m3l1k4/Capstone_F19_Group_110/3D CAD/smarties-16.JPG

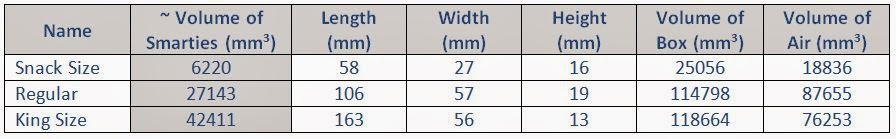
3D CAD/smarties-16.JPG
