m3l1k4/Capstone_F19_Group_110/documents/proposal/20191010 - Presentation.pptx

## Recap

- Over last two weeks,
  - Started brainstorming solutions for product
  - Compiling list of components we need and the anticipated cost
- Met with client yesterday
  - Primary contact + technical contact present
  - Discussed potential solutions that will integrate within their POS system
    - The system is a black box , so this is important

## RCGs

Requirements | Constraints | Goals
Wireless communication (between end and edge device) | End to edge must use low power , low bandwidth protocol. Ex; zigbee | Scalable
Low power consumption (IoT) | End to cloud must be use high bandwidth ex; wifi or ethernet | Low production cost
MS Azure
Real time data handling

## Should have

- Wireless communication
- low power consumption
- Configure to handle microsoft Azure API
- Scalable
- Real time data handling

## Could Have or nice to have

- Run on rechargeable batteries
- Minimalistic azure developed UI

## Will not have ( at this time)

- Multiple end devices
- Interchangeable high bandwidth communication protocol ( i.e. can switch from http to mqtt depending on the environment)
- Interchangeable low bandwidth protocol

## Overview of System

Upstream; Azure IoT hub

Data abstraction middle layer

Container 1

s1

s2

s3

Container 2

s1

s2

s3

Container 3

s1

s2

s3

1. End device (with weight sensor) sends data to Edge device (middle layer) via IoT protocol. Zigbee is being considered.
2. Edge device sends data to Azure IoT Cloud via internet protocol (Wifi, Ethernet)
3. User is able to access data from End devices from Azure Interface

## Slide 7

End Device

Low band communication and processing unit

sensors

Edge Device

low band com processing unit

Processing RAM

High band communication unit

IoT Hub

## Milestones

1. Individual hardware components at a functional level
  a. End device (sensor + communication module)
  b. Edge device (communication module for end device and IoT)
2. Integration into one system
  a. End device to Edge device
  b. Edge device to IoT Hub
3. MS Azure User Interface
  a. Develop a UI using MS Azure

## Project Timeline

- Design will be finalized soon after proposal
- Begin ordering misc parts as soon as account is open
  - Client is checking their inventory for dev boards and suggested to order major components under $100 through.
  - We are checking our own inventory from previous projects
- 2-3 weeks per ‘mini project’: configuration + troubleshooting

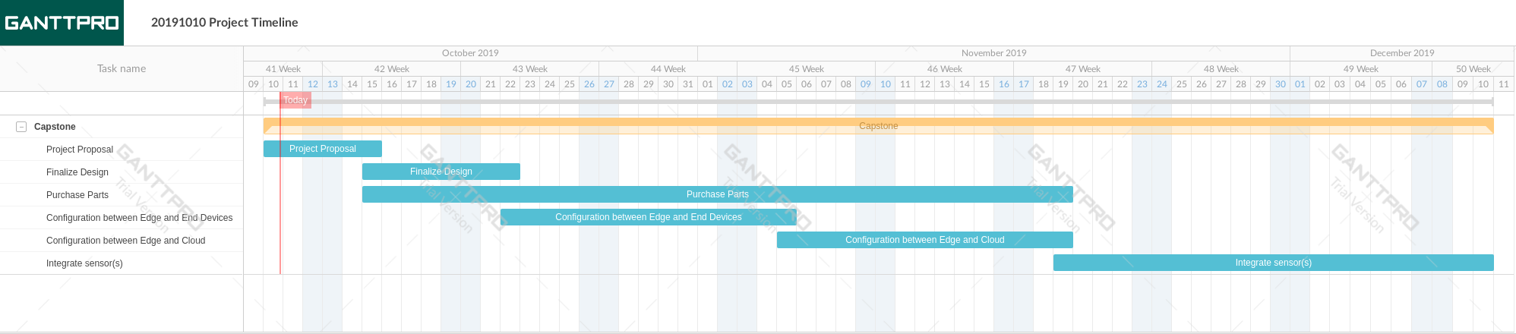
[picture p14: figure]

## Technical Task Distribution based on skill-set

| Ammar | Melika | Wency | Adil
Skill Area | Low bandwidth Communication protocols integration ( end devices) | Cloud integration ( edge devices) | Data handling software , and software QA | Hardware-software integration
Notes of concern | Currently out of the country. Anticipated to be back on the 14th | | | Laptop recently water damaged

## Non-technical task distribution

- We all are communicating through one email screen name, so admin tasks have been done based on who is free to do it the earliest
- Everyone is listed as a delegate and has access to mailbox
- This is run quickly by other members either in person or in memos, to avoid duplicate emails, tasks etc.

Notes: To do : azure email
