m3l1k4/Capstone_F19_Group_110/Meeting Notes/software achitecture 20190131.docx

IoT inventory software architecture
End Device
Intermediate connection XBEE
Edge Device
load sensor to arduino
weight data calib*
xbee to pi
Xbee
arduino to xbee
xbee string prep
Load Sensor Read
Load Sensor data QA ( -1,0,1)
pi to azure
Send Data
String: { weight, device ID etc.}
Read xbee serial data ( libraries)
use voltage-weight ratio table or send raw data*
wait for ping from pi to send
Ping End Device to request data
Wait for data
Ping End device to confirm reciept
(will need if getting raw data)
send
wait for reciept confirmation
ISR for data retrieving from multiple end devices
clean up string
format data values for table insertion
(only one string can be sent per API request)
recieve from formatter function
start API request to insert
Get Data
( this script already exists)
( this script already exists)
(Arduino Xbee libraries for sending data)
