m3l1k4/Capstone_F19_Group_110/minicloud/minicloud-master/Architecture/AWS_IoT.png

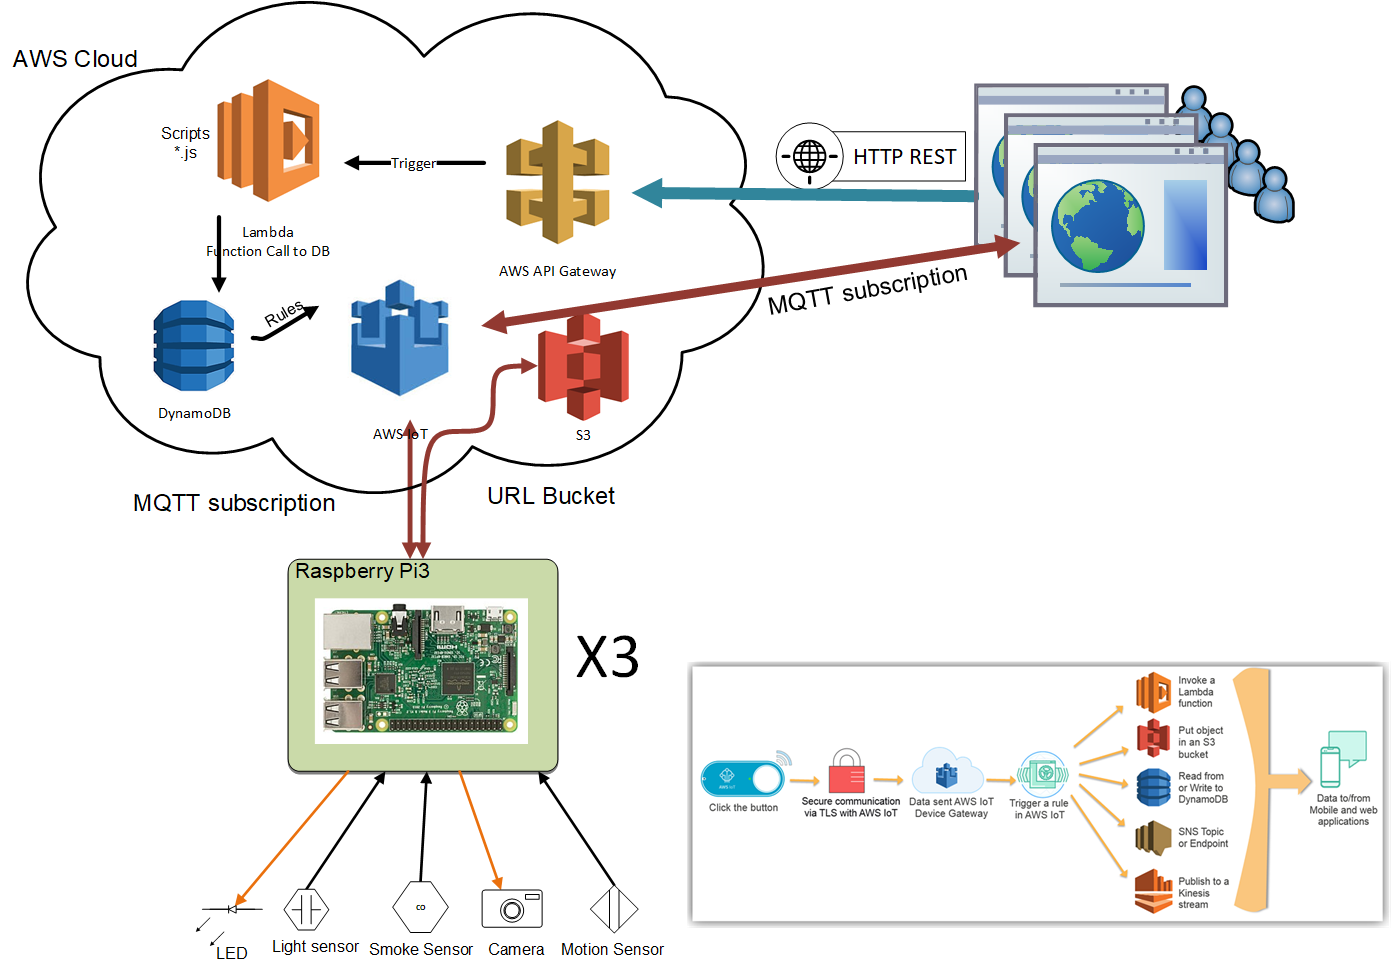
minicloud/minicloud-master/Architecture/AWS_IoT.png
