m3l1k4/Capstone_F19_Group_110/minicloud/minicloud-master/Architecture/template_xml_json.PNG

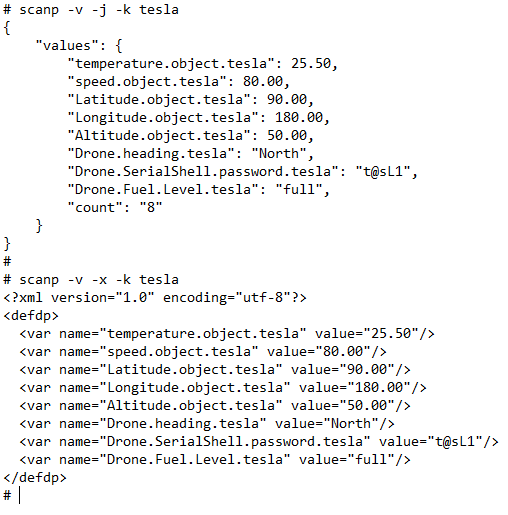
minicloud/minicloud-master/Architecture/template_xml_json.PNG
