m3l1k4/Capstone_F19_Group_110/Capstone Parts.xlsx

Manufacturer | Manufacturer Part Number | Seller | Digi-Key Part Number | Quantity | Link | Description | Unit Price | Net Price
DFRobot | DFR0015 | Digi-Key | 1738-1230-ND | 1 | https://tinyurl.com/y4jpyzoq | XBEE SHIELD FOR ARDUINO | 15.91 | 15.91
SparkFun Electronics | WRL-11812 | Digi-Key | 1568-1305-ND | 1 | https://tinyurl.com/yynkofbn | SPARKFUN XBEE EXPLORER USB | 37.13 | 37.13
Siretta Ltd | DELTA8A/X/SMAM/RP/S/17 - GREY | Digi-Key | DELTA8A/X/SMAM/RP/S/17-GREY-ND | 2 | https://tinyurl.com/y3pwvsl9 | RF ANT 2.4GHZ WHIP STR RP-SMA ML | 9.59 | 19.18
Digi International | XBP24CZ7SIT-004 | Digi-Key | 602-1562-ND | 2 | https://tinyurl.com/yxoxxojz | RF TXRX MODULE 802.15.4 RP-SMA | 49.62 | 99.24
 |  |  |  |  |  |  | Total Price | 171.46
