m3l1k4/Capstone_F19_Group_110/Solidworks files/Milestone 3.SLDASM

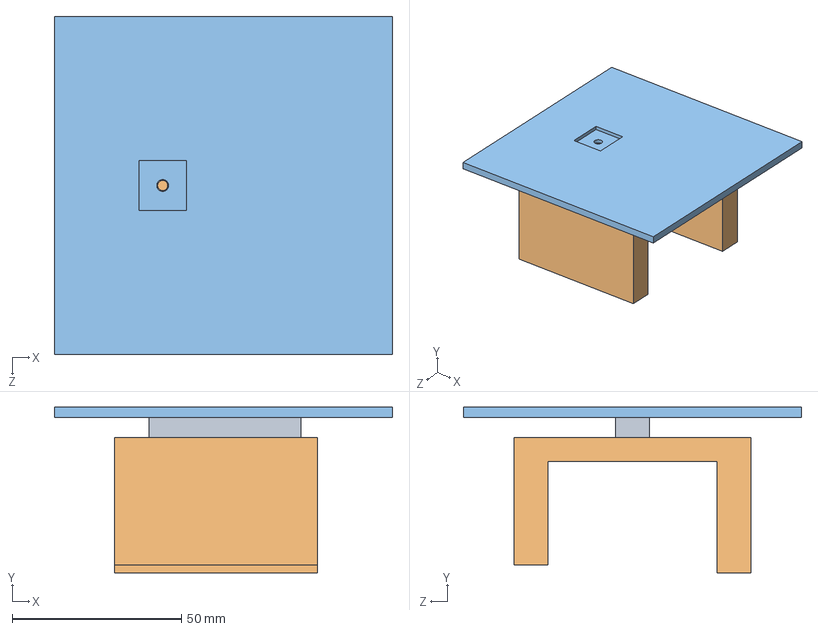
[picture p47: CAD file, 2020-02-27]
Solidworks files/Milestone 3.SLDASM
100.0 x 49.0 x 100.0 mm
Load cell
Load cell dock
Pressure plate proto
