m3l1k4/Capstone_F19_Group_110/3D CAD/dispneser 150x150 v26.stl

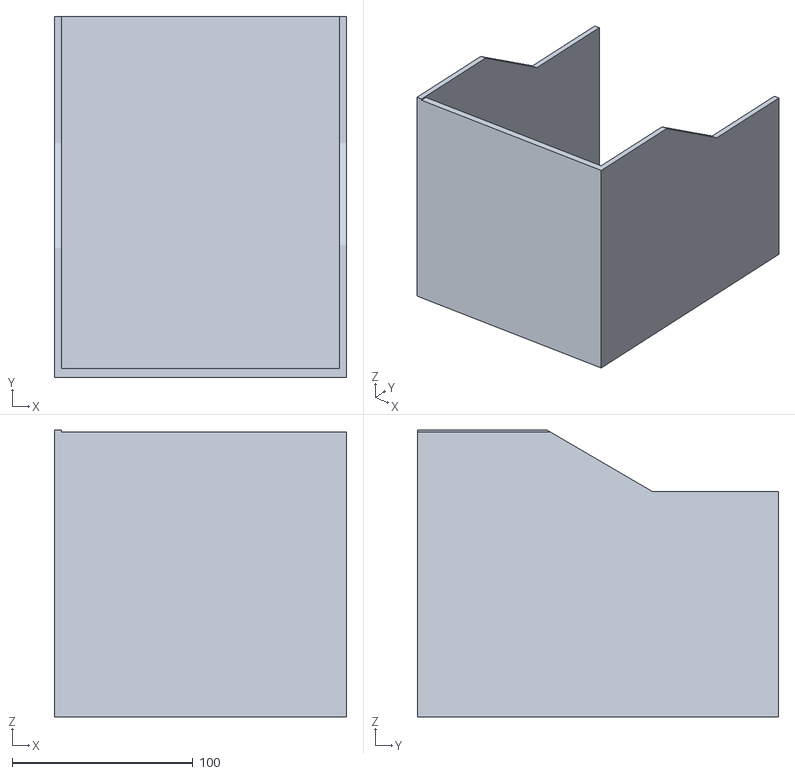
[picture p48: CAD file, 2020-03-04]
3D CAD/dispneser 150x150 v26.stl
161.9 x 200.0 x 159.0
