m3l1k4/Capstone_F19_Group_110/Solidworks files/Load cell dock.SLDPRT

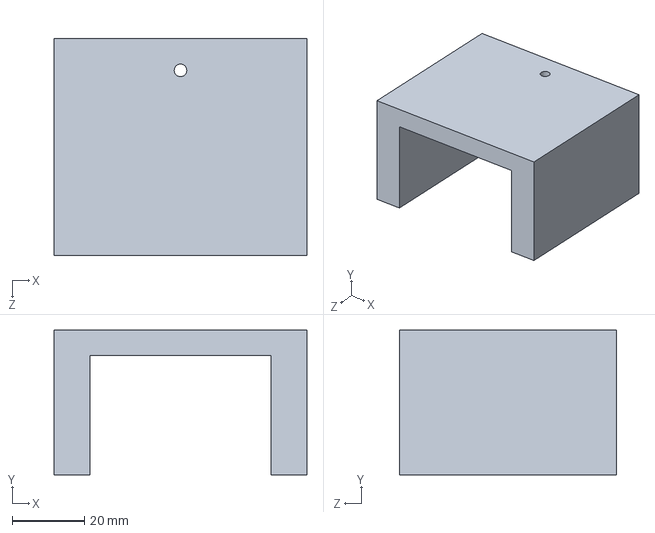
[picture p49: CAD file, 2020-04-04]
Solidworks files/Load cell dock.SLDPRT
70.0 x 40.0 x 60.0 mm
