m3l1k4/Capstone_F19_Group_110/Solidworks files/Load cell.SLDPRT

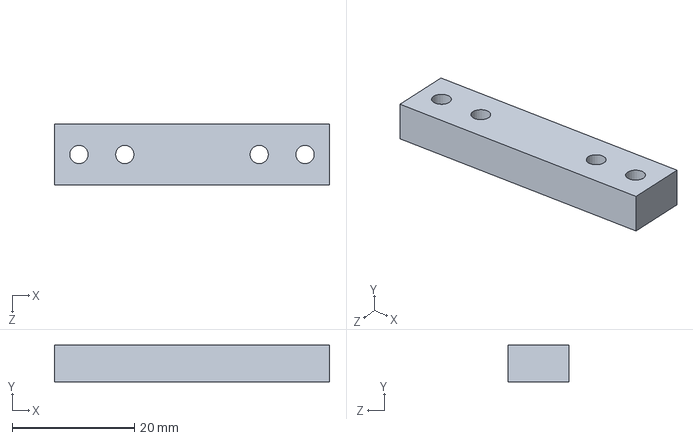
[picture p50: CAD file, 2020-02-27]
Solidworks files/Load cell.SLDPRT
45.0 x 6.00 x 10.0 mm
