m3l1k4/Capstone_F19_Group_110/Solidworks files/Pressure plate proto.SLDPRT

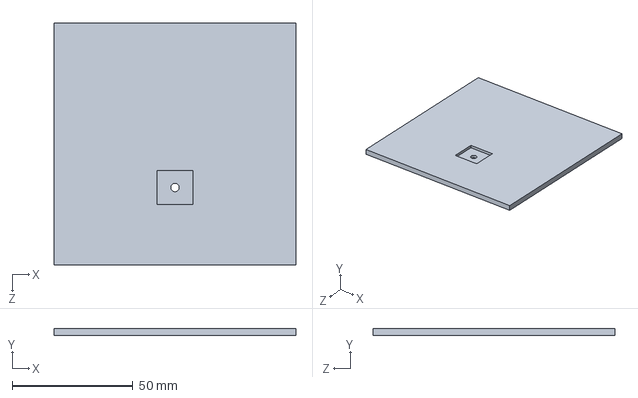
[picture p51: CAD file, 2020-02-27]
Solidworks files/Pressure plate proto.SLDPRT
100.0 x 3.00 x 100.0 mm
