m3l1k4/Capstone_F19_Group_110/(list of files, cad)

Other CAD files:
Solidworks files/Load cell dock.SLDDRW
Solidworks files/Load cell dock.STL
Solidworks files/Pressure plate proto.SLDDRW
Solidworks files/Pressure plate proto.STL
