m3l1k4/Capstone_F19_Group_110/Meeting Notes/software achitecture 20190130.pdf

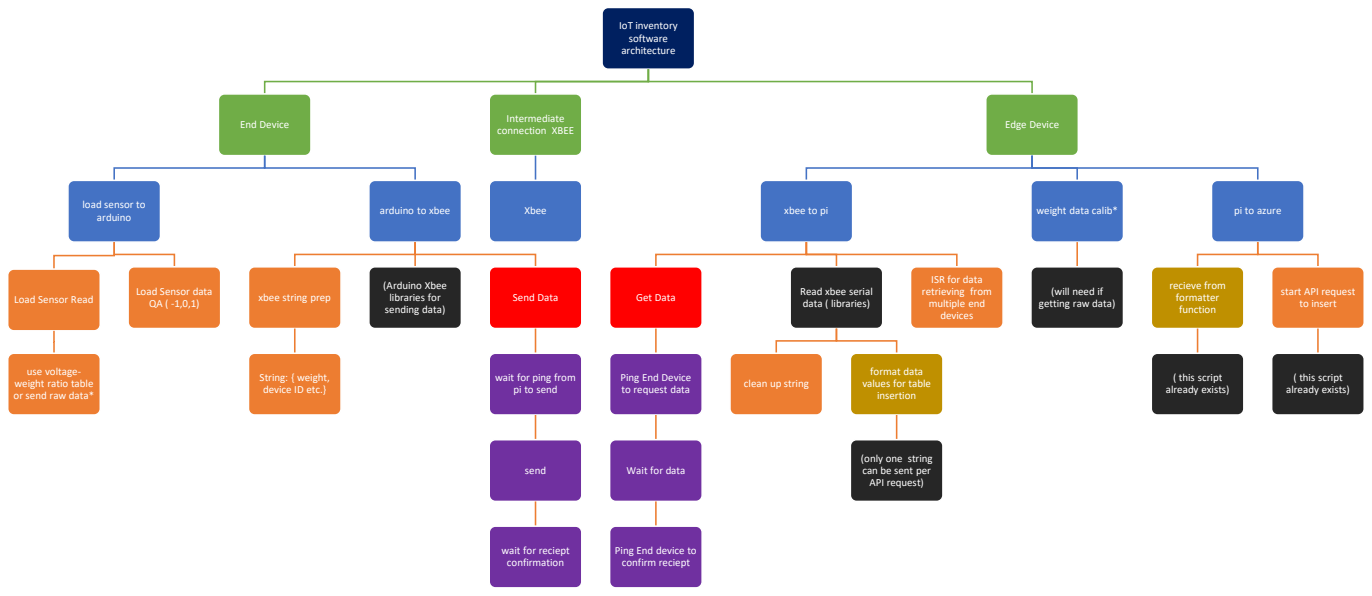
[picture p53: page 1]
IoT inventory software architecture; End Device; (Arduino Xbee libraries for sending data); Send Data; send; Intermediate connection XBEE; Xbee; Edge Device; Get Data; recieve from formatter function; ( this script already exists)

load sensor to
arduino

arduino to xbee

xbee to pi

weight data calib*

pi to azure

ISR for data
retrieving from
multiple end
devices

Load Sensor data

xbee string prep

Read xbee serial
data ( libraries)

(will need if
getting raw data)

start API request
to insert

Load Sensor Read

use voltage-
weight ratio table
or send raw data*

format data
values for table
insertion

String: { weight,
device ID etc.}

wait for ping from
pi to send

Ping End Device
to request data

clean up string

(only one string
can be sent per
API request)

Wait for data

wait for reciept
confirmation

Ping End device to
confirm reciept
