m3l1k4/Capstone_F19_Group_110/Load_cell/HX711-Load-Cell-Amplifier-master/HX711-Load-Cell-Amplifier-master/Production/SparkFun_HX711_Load_Cell-Panel-v11.brd

## EAGLE design Load_cell/HX711-Load-Cell-Amplifier-master/HX711-Load-Cell-Amplifier-master/Production/SparkFun_HX711_Load_Cell-Panel-v11.brd (2020-04-04)

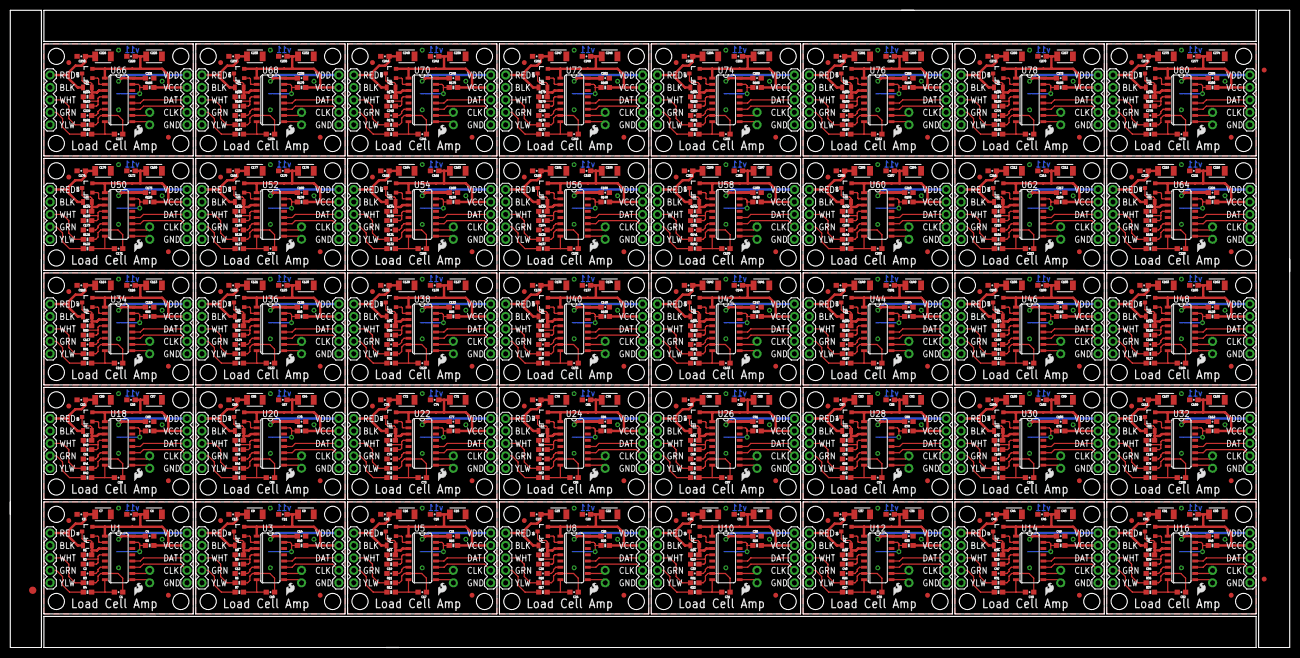
[picture p57: board SparkFun_HX711_Load_Cell-Panel-v11.brd from above]

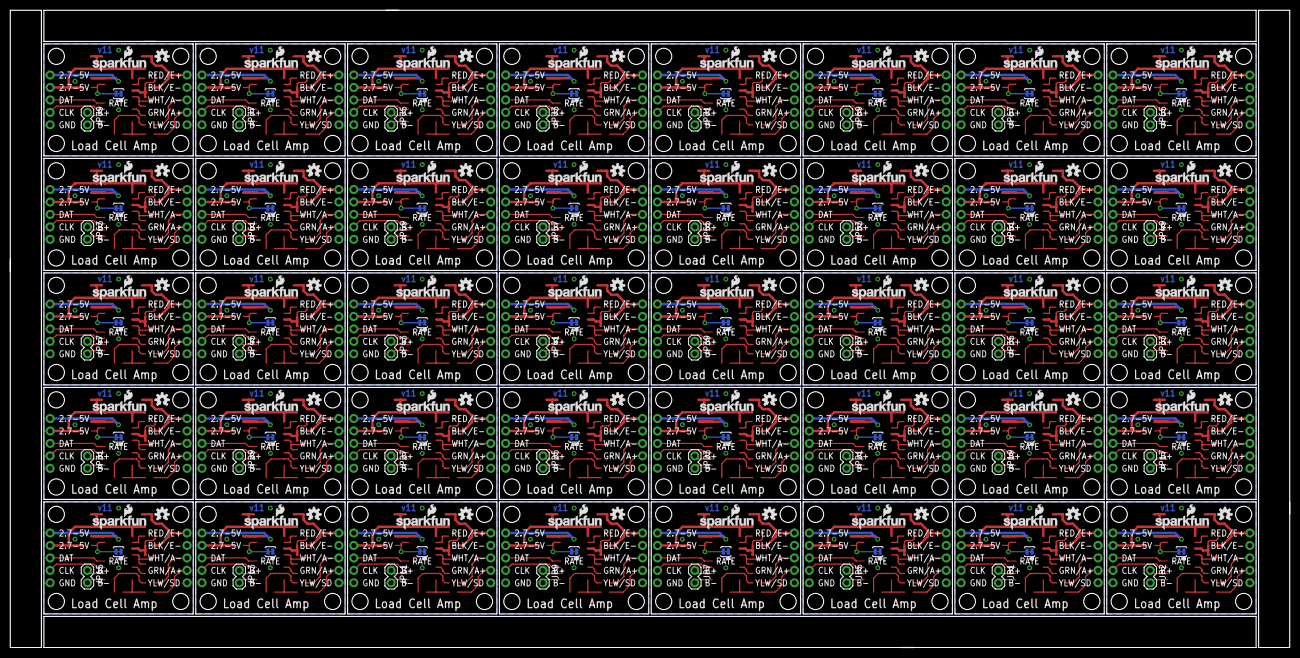
[picture p58: board SparkFun_HX711_Load_Cell-Panel-v11.brd from below]

Board: 2 copper layers, 261.1 x 130.0 mm, 1123 parts (160 on the bottom side), 680 nets.

Parts:
C1, C2, C3, C4, C5, C10, C11, C12, C13, C14, C17, C18, C19, C20, C21, C24, C25, C26, C27, C28, C31, C32, C33, C34, C35, C38, C39, C40, C41, C42, C45, C46, C47, C48, C49, C52, C53, C54, C55, C56, C59, C60, C61, C62, C63, C66, C67, C68, C69, C70, C73, C74, C75, C76, C77, C80, C81, C82, C83, C84, C87, C88, C89, C90, C91, C94, C95, C96, C97, C98, C101, C102, C103, C104, C105, C108, C109, C110, C111, C112, C115, C116, C117, C118, C119, C122, C123, C124, C125, C126, C129, C130, C131, C132, C133, C136, C137, C138, C139, C140, C143, C144, C145, C146, C147, C150, C151, C152, C153, C154, C157, C158, C159, C160, C161, C164, C165, C166, C167, C168, C171, C172, C173, C174, C175, C178, C179, C180, C181, C182, C185, C186, C187, C188, C189, C192, C193, C194, C195, C196, C199, C200, C201, C202, C203, C206, C207, C208, C209, C210, C213, C214, C215, C216, C217, C220, C221, C222, C223, C224, C227, C228, C229, C230, C231, C234, C235, C236, C237, C238, C241, C242, C243, C244, C245, C248, C249, C250, C251, C252, C255, C256, C257, C258, C259, C262, C263, C264, C265, C266, C269, C270, C271, C272, C273, C276, C277, C278, C279, C280: 0.1uF; 0603-CAP
C6, C7, C8, C9, C15, C16, C22, C23, C29, C30, C36, C37, C43, C44, C50, C51, C57, C58, C64, C65, C71, C72, C78, C79, C85, C86, C92, C93, C99, C100, C106, C107, C113, C114, C120, C121, C127, C128, C134, C135, C141, C142, C148, C149, C155, C156, C162, C163, C169, C170, C176, C177, C183, C184, C190, C191, C197, C198, C204, C205, C211, C212, C218, C219, C225, C226, C232, C233, C239, C240, C246, C247, C253, C254, C260, C261, C267, C268, C274, C275: 10uF; 1210
E$1: FIDUCIAL-1.5X3
E$5, E$6: FIDUCIAL-1X2
FID1, FID2, FID3, FID4, FID5, FID6, FID7, FID8, FID9, FID10, FID11, FID12, FID13, FID14, FID15, FID16, FID17, FID18, FID19, FID20, FID21, FID22, FID23, FID24, FID25, FID26, FID27, FID28, FID29, FID30, FID31, FID32, FID33, FID34, FID35, FID36, FID37, FID38, FID39, FID40, FID41, FID42, FID43, FID44, FID45, FID46, FID47, FID48, FID49, FID50, FID51, FID52, FID53, FID54, FID55, FID56, FID57, FID58, FID59, FID60, FID61, FID62, FID63, FID64, FID65, FID66, FID67, FID68, FID69, FID70, FID71, FID72, FID73, FID74, FID75, FID76, FID77, FID78, FID79, FID80: FIDUCIAL1X2; FIDUCIAL-1X2
J1, J2, J3, J4, J5, J6, J7, J8, J9, J10, J11, J12, J13, J14, J15, J16, J17, J18, J19, J20, J21, J22, J23, J24, J25, J26, J27, J28, J29, J30, J31, J32, J33, J34, J35, J36, J37, J38, J39, J40: 1X05
JP1, JP2, JP5, JP7, JP9, JP11, JP13, JP15, JP17, JP19, JP21, JP23, JP25, JP27, JP29, JP31, JP33, JP35, JP37, JP39, JP41, JP43, JP45, JP47, JP49, JP51, JP53, JP55, JP57, JP59, JP61, JP63, JP65, JP67, JP69, JP71, JP73, JP75, JP77, JP79: 1X02
JP3, JP4, JP6, JP8, JP10, JP12, JP14, JP16, JP18, JP20, JP22, JP24, JP26, JP28, JP30, JP32, JP34, JP36, JP38, JP40, JP42, JP44, JP46, JP48, JP50, JP52, JP54, JP56, JP58, JP60, JP62, JP64, JP66, JP68, JP70, JP72, JP74, JP76, JP78, JP80: 1X05
L1, L2, L3, L4, L5, L6, L7, L8, L9, L10, L11, L12, L13, L14, L15, L16, L17, L18, L19, L20, L21, L22, L23, L24, L25, L26, L27, L28, L29, L30, L31, L32, L33, L34, L35, L36, L37, L38, L39, L40: 3.3uH; 0805
LOGO1, LOGO2, LOGO5, LOGO7, LOGO9, LOGO11, LOGO13, LOGO15, LOGO17, LOGO19, LOGO21, LOGO23, LOGO25, LOGO27, LOGO29, LOGO31, LOGO33, LOGO35, LOGO37, LOGO39, LOGO41, LOGO43, LOGO45, LOGO47, LOGO49, LOGO51, LOGO53, LOGO55, LOGO57, LOGO59, LOGO61, LOGO63, LOGO65, LOGO67, LOGO69, LOGO71, LOGO73, LOGO75, LOGO77, LOGO79: SFE_LOGO_NAME_FLAME.1_INCH; SFE_LOGO_NAME_FLAME_.1
LOGO3, LOGO4, LOGO6, LOGO8, LOGO10, LOGO12, LOGO14, LOGO16, LOGO18, LOGO20, LOGO22, LOGO24, LOGO26, LOGO28, LOGO30, LOGO32, LOGO34, LOGO36, LOGO38, LOGO40, LOGO42, LOGO44, LOGO46, LOGO48, LOGO50, LOGO52, LOGO54, LOGO56, LOGO58, LOGO60, LOGO62, LOGO64, LOGO66, LOGO68, LOGO70, LOGO72, LOGO74, LOGO76, LOGO78, LOGO80: SFE_LOGO_FLAME.1_INCH; SFE_LOGO_FLAME_.1
Q1, Q2, Q3, Q4, Q5, Q6, Q7, Q8, Q9, Q10, Q11, Q12, Q13, Q14, Q15, Q16, Q17, Q18, Q19, Q20, Q21, Q22, Q23, Q24, Q25, Q26, Q27, Q28, Q29, Q30, Q31, Q32, Q33, Q34, Q35, Q36, Q37, Q38, Q39, Q40: MMBT4403; SOT23-3
R1, R9, R14, R19, R24, R29, R34, R39, R44, R49, R54, R59, R64, R69, R74, R79, R84, R89, R94, R99, R104, R109, R114, R119, R124, R129, R134, R139, R144, R149, R154, R159, R164, R169, R174, R179, R184, R189, R194, R199: 20k; 0603-RES
R2, R8, R13, R18, R23, R28, R33, R38, R43, R48, R53, R58, R63, R68, R73, R78, R83, R88, R93, R98, R103, R108, R113, R118, R123, R128, R133, R138, R143, R148, R153, R158, R163, R168, R173, R178, R183, R188, R193, R198: 8.2K; 0603-RES
R3, R4, R6, R7, R11, R12, R16, R17, R21, R22, R26, R27, R31, R32, R36, R37, R41, R42, R46, R47, R51, R52, R56, R57, R61, R62, R66, R67, R71, R72, R76, R77, R81, R82, R86, R87, R91, R92, R96, R97, R101, R102, R106, R107, R111, R112, R116, R117, R121, R122, R126, R127, R131, R132, R136, R137, R141, R142, R146, R147, R151, R152, R156, R157, R161, R162, R166, R167, R171, R172, R176, R177, R181, R182, R186, R187, R191, R192, R196, R197: 100; 0603-RES
R5, R10, R15, R20, R25, R30, R35, R40, R45, R50, R55, R60, R65, R70, R75, R80, R85, R90, R95, R100, R105, R110, R115, R120, R125, R130, R135, R140, R145, R150, R155, R160, R165, R170, R175, R180, R185, R190, R195, R200: 10K; 0603-RES
SJ1, SJ2, SJ3, SJ4, SJ5, SJ6, SJ7, SJ8, SJ9, SJ10, SJ11, SJ12, SJ13, SJ14, SJ15, SJ16, SJ17, SJ18, SJ19, SJ20, SJ21, SJ22, SJ23, SJ24, SJ25, SJ26, SJ27, SJ28, SJ29, SJ30, SJ31, SJ32, SJ33, SJ34, SJ35, SJ36, SJ37, SJ38, SJ39, SJ40: PAD-JUMPER-2-NC_BY_TRACE_YES_SILK
STANDOFF1, STANDOFF2, STANDOFF3, STANDOFF4, STANDOFF5, STANDOFF6, STANDOFF7, STANDOFF8, STANDOFF9, STANDOFF10, STANDOFF11, STANDOFF12, STANDOFF13, STANDOFF14, STANDOFF15, STANDOFF16, STANDOFF17, STANDOFF18, STANDOFF19, STANDOFF20, STANDOFF21, STANDOFF22, STANDOFF23, STANDOFF24, STANDOFF25, STANDOFF26, STANDOFF27, STANDOFF28, STANDOFF29, STANDOFF30, STANDOFF31, STANDOFF32, STANDOFF33, STANDOFF34, STANDOFF35, STANDOFF36, STANDOFF37, STANDOFF38, STANDOFF39, STANDOFF40, STANDOFF41, STANDOFF42, STANDOFF43, STANDOFF44, STANDOFF45, STANDOFF46, STANDOFF47, STANDOFF48, STANDOFF49, STANDOFF50, STANDOFF51, STANDOFF52, STANDOFF53, STANDOFF54, STANDOFF55, STANDOFF56, STANDOFF57, STANDOFF58, STANDOFF59, STANDOFF60, STANDOFF61, STANDOFF62, STANDOFF63, STANDOFF64, STANDOFF65, STANDOFF66, STANDOFF67, STANDOFF68, STANDOFF69, STANDOFF70, STANDOFF71, STANDOFF72, STANDOFF73, STANDOFF74, STANDOFF75, STANDOFF76, STANDOFF77, STANDOFF78, STANDOFF79, STANDOFF80, STANDOFF81, STANDOFF82, STANDOFF83, STANDOFF84, STANDOFF85, STANDOFF86, STANDOFF87, STANDOFF88, STANDOFF89, STANDOFF90, STANDOFF91, STANDOFF92, STANDOFF93, STANDOFF94, STANDOFF95, STANDOFF96, STANDOFF97, STANDOFF98, STANDOFF99, STANDOFF100, STANDOFF101, STANDOFF102, STANDOFF103, STANDOFF104, STANDOFF105, STANDOFF106, STANDOFF107, STANDOFF108, STANDOFF109, STANDOFF110, STANDOFF111, STANDOFF112, STANDOFF113, STANDOFF114, STANDOFF115, STANDOFF116, STANDOFF117, STANDOFF118, STANDOFF119, STANDOFF120, STANDOFF121, STANDOFF122, STANDOFF123, STANDOFF124, STANDOFF125, STANDOFF126, STANDOFF127, STANDOFF128, STANDOFF129, STANDOFF130, STANDOFF131, STANDOFF132, STANDOFF133, STANDOFF134, STANDOFF135, STANDOFF136, STANDOFF137, STANDOFF138, STANDOFF139, STANDOFF140, STANDOFF141, STANDOFF142, STANDOFF143, STANDOFF144, STANDOFF145, STANDOFF146, STANDOFF147, STANDOFF148, STANDOFF149, STANDOFF150, STANDOFF151, STANDOFF152, STANDOFF153, STANDOFF154, STANDOFF155, STANDOFF156, STANDOFF157, STANDOFF158, STANDOFF159, STANDOFF160: STAND-OFF
U1, U3, U5, U8, U10, U12, U14, U16, U18, U20, U22, U24, U26, U28, U30, U32, U34, U36, U38, U40, U42, U44, U46, U48, U50, U52, U54, U56, U58, U60, U62, U64, U66, U68, U70, U72, U74, U76, U78, U80: HX711; SO16
U2, U4, U6, U7, U9, U11, U13, U15, U17, U19, U21, U23, U25, U27, U29, U31, U33, U35, U37, U39, U41, U43, U45, U47, U49, U51, U53, U55, U57, U59, U61, U63, U65, U67, U69, U71, U73, U75, U77, U79: OSHW-LOGOS; OSHW-LOGO-S

Connections:
A+: JP4.2, R4.1
A+1: JP3.2, R7.1
A+2: JP6.2, R12.1
A+3: JP8.2, R17.1
A+4: JP10.2, R22.1
A+5: JP12.2, R27.1
A+6: JP14.2, R32.1
A+7: JP16.2, R37.1
A+8: JP18.2, R42.1
A+9: JP20.2, R47.1
A+10: JP22.2, R52.1
A+11: JP24.2, R57.1
A+12: JP26.2, R62.1
A+13: JP28.2, R67.1
A+14: JP30.2, R72.1
A+15: JP32.2, R77.1
A+16: JP34.2, R82.1
A+17: JP36.2, R87.1
A+18: JP38.2, R92.1
A+19: JP40.2, R97.1
A+20: JP42.2, R102.1
A+21: JP44.2, R107.1
A+22: JP46.2, R112.1
A+23: JP48.2, R117.1
A+24: JP50.2, R122.1
A+25: JP52.2, R127.1
A+26: JP54.2, R132.1
A+27: JP56.2, R137.1
A+28: JP58.2, R142.1
A+29: JP60.2, R147.1
A+30: JP62.2, R152.1
A+31: JP64.2, R157.1
A+32: JP66.2, R162.1
A+33: JP68.2, R167.1
A+34: JP70.2, R172.1
A+35: JP72.2, R177.1
A+36: JP74.2, R182.1
A+37: JP76.2, R187.1
A+38: JP78.2, R192.1
A+39: JP80.2, R197.1
A-: JP4.3, R3.1
A-1: JP3.3, R6.1
A-2: JP6.3, R11.1
A-3: JP8.3, R16.1
A-4: JP10.3, R21.1
A-5: JP12.3, R26.1
A-6: JP14.3, R31.1
A-7: JP16.3, R36.1
A-8: JP18.3, R41.1
A-9: JP20.3, R46.1
A-10: JP22.3, R51.1
A-11: JP24.3, R56.1
A-12: JP26.3, R61.1
A-13: JP28.3, R66.1
A-14: JP30.3, R71.1
A-15: JP32.3, R76.1
A-16: JP34.3, R81.1
A-17: JP36.3, R86.1
A-18: JP38.3, R91.1
A-19: JP40.3, R96.1
A-20: JP42.3, R101.1
A-21: JP44.3, R106.1
A-22: JP46.3, R111.1
A-23: JP48.3, R116.1
A-24: JP50.3, R121.1
A-25: JP52.3, R126.1
A-26: JP54.3, R131.1
A-27: JP56.3, R136.1
A-28: JP58.3, R141.1
A-29: JP60.3, R146.1
A-30: JP62.3, R151.1
A-31: JP64.3, R156.1
A-32: JP66.3, R161.1
A-33: JP68.3, R166.1
A-34: JP70.3, R171.1
A-35: JP72.3, R176.1
A-36: JP74.3, R181.1
A-37: JP76.3, R186.1
A-38: JP78.3, R191.1
A-39: JP80.3, R196.1
AVDD: C3.1, C7.1, JP4.5, L1.1
AVDD1: C9.1, C13.1, JP3.5, L2.1
AVDD2: C16.1, C20.1, JP6.5, L3.1
AVDD3: C23.1, C27.1, JP8.5, L4.1
AVDD4: C30.1, C34.1, JP10.5, L5.1
AVDD5: C37.1, C41.1, JP12.5, L6.1
AVDD6: C44.1, C48.1, JP14.5, L7.1
AVDD7: C51.1, C55.1, JP16.5, L8.1
AVDD8: C58.1, C62.1, JP18.5, L9.1
AVDD9: C65.1, C69.1, JP20.5, L10.1
AVDD10: C72.1, C76.1, JP22.5, L11.1
AVDD11: C79.1, C83.1, JP24.5, L12.1
AVDD12: C86.1, C90.1, JP26.5, L13.1
AVDD13: C93.1, C97.1, JP28.5, L14.1
AVDD14: C100.1, C104.1, JP30.5, L15.1
AVDD15: C107.1, C111.1, JP32.5, L16.1
AVDD16: C114.1, C118.1, JP34.5, L17.1
AVDD17: C121.1, C125.1, JP36.5, L18.1
AVDD18: C128.1, C132.1, JP38.5, L19.1
AVDD19: C135.1, C139.1, JP40.5, L20.1
AVDD20: C142.1, C146.1, JP42.5, L21.1
AVDD21: C149.1, C153.1, JP44.5, L22.1
AVDD22: C156.1, C160.1, JP46.5, L23.1
AVDD23: C163.1, C167.1, JP48.5, L24.1
AVDD24: C170.1, C174.1, JP50.5, L25.1
AVDD25: C177.1, C181.1, JP52.5, L26.1
AVDD26: C184.1, C188.1, JP54.5, L27.1
AVDD27: C191.1, C195.1, JP56.5, L28.1
AVDD28: C198.1, C202.1, JP58.5, L29.1
AVDD29: C205.1, C209.1, JP60.5, L30.1
AVDD30: C212.1, C216.1, JP62.5, L31.1
AVDD31: C219.1, C223.1, JP64.5, L32.1
AVDD32: C226.1, C230.1, JP66.5, L33.1
AVDD33: C233.1, C237.1, JP68.5, L34.1
AVDD34: C240.1, C244.1, JP70.5, L35.1
AVDD35: C247.1, C251.1, JP72.5, L36.1
AVDD36: C254.1, C258.1, JP74.5, L37.1
AVDD37: C261.1, C265.1, JP76.5, L38.1
AVDD38: C268.1, C272.1, JP78.5, L39.1
AVDD39: C275.1, C279.1, JP80.5, L40.1
B+: JP2.1, U1.10
B+1: JP1.1, U3.10
B+2: JP5.1, U5.10
B+3: JP7.1, U8.10
B+4: JP9.1, U10.10
B+5: JP11.1, U12.10
B+6: JP13.1, U14.10
B+7: JP15.1, U16.10
B+8: JP17.1, U18.10
B+9: JP19.1, U20.10
B+10: JP21.1, U22.10
B+11: JP23.1, U24.10
B+12: JP25.1, U26.10
B+13: JP27.1, U28.10
B+14: JP29.1, U30.10
B+15: JP31.1, U32.10
B+16: JP33.1, U34.10
B+17: JP35.1, U36.10
B+18: JP37.1, U38.10
B+19: JP39.1, U40.10
B+20: JP41.1, U42.10
B+21: JP43.1, U44.10
B+22: JP45.1, U46.10
B+23: JP47.1, U48.10
B+24: JP49.1, U50.10
B+25: JP51.1, U52.10
B+26: JP53.1, U54.10
B+27: JP55.1, U56.10
B+28: JP57.1, U58.10
B+29: JP59.1, U60.10
B+30: JP61.1, U62.10
B+31: JP63.1, U64.10
B+32: JP65.1, U66.10
B+33: JP67.1, U68.10
B+34: JP69.1, U70.10
B+35: JP71.1, U72.10
B+36: JP73.1, U74.10
B+37: JP75.1, U76.10
B+38: JP77.1, U78.10
B+39: JP79.1, U80.10
B-: JP2.2, U1.9
B-1: JP1.2, U3.9
B-2: JP5.2, U5.9
B-3: JP7.2, U8.9
B-4: JP9.2, U10.9
B-5: JP11.2, U12.9
B-6: JP13.2, U14.9
B-7: JP15.2, U16.9
B-8: JP17.2, U18.9
B-9: JP19.2, U20.9
B-10: JP21.2, U22.9
B-11: JP23.2, U24.9
B-12: JP25.2, U26.9
B-13: JP27.2, U28.9
B-14: JP29.2, U30.9
B-15: JP31.2, U32.9
B-16: JP33.2, U34.9
B-17: JP35.2, U36.9
B-18: JP37.2, U38.9
B-19: JP39.2, U40.9
B-20: JP41.2, U42.9
B-21: JP43.2, U44.9
B-22: JP45.2, U46.9
B-23: JP47.2, U48.9
B-24: JP49.2, U50.9
B-25: JP51.2, U52.9
B-26: JP53.2, U54.9
B-27: JP55.2, U56.9
B-28: JP57.2, U58.9
B-29: JP59.2, U60.9
B-30: JP61.2, U62.9
B-31: JP63.2, U64.9
B-32: JP65.2, U66.9
B-33: JP67.2, U68.9
B-34: JP69.2, U70.9
B-35: JP71.2, U72.9
B-36: JP73.2, U74.9
B-37: JP75.2, U76.9
B-38: JP77.2, U78.9
B-39: JP79.2, U80.9
DAT: J1.3, U1.12
DAT1: J2.3, U3.12
DAT2: J3.3, U5.12
DAT3: J4.3, U8.12
DAT4: J5.3, U10.12
DAT5: J6.3, U12.12
DAT6: J7.3, U14.12
DAT7: J8.3, U16.12
DAT8: J9.3, U18.12
DAT9: J10.3, U20.12
DAT10: J11.3, U22.12
DAT11: J12.3, U24.12
DAT12: J13.3, U26.12
DAT13: J14.3, U28.12
DAT14: J15.3, U30.12
DAT15: J16.3, U32.12
DAT16: J17.3, U34.12
DAT17: J18.3, U36.12
DAT18: J19.3, U38.12
DAT19: J20.3, U40.12
DAT20: J21.3, U42.12
DAT21: J22.3, U44.12
DAT22: J23.3, U46.12
DAT23: J24.3, U48.12
DAT24: J25.3, U50.12
DAT25: J26.3, U52.12
DAT26: J27.3, U54.12
DAT27: J28.3, U56.12
DAT28: J29.3, U58.12
DAT29: J30.3, U60.12
DAT30: J31.3, U62.12
DAT31: J32.3, U64.12
DAT32: J33.3, U66.12
DAT33: J34.3, U68.12
DAT34: J35.3, U70.12
DAT35: J36.3, U72.12
DAT36: J37.3, U74.12
DAT37: J38.3, U76.12
DAT38: J39.3, U78.12
DAT39: J40.3, U80.12
GND: C2.1, C3.2, C4.2, C5.2, C6.2, C7.2, J1.5, JP4.1, JP4.4, R2.1, SJ2.1, U1.5, U1.14
GND1: C8.2, C9.2, C11.2, C12.1, C13.2, C14.2, J2.5, JP3.1, JP3.4, R8.1, SJ1.1, U3.5, U3.14
GND2: C15.2, C16.2, C18.2, C19.1, C20.2, C21.2, J3.5, JP6.1, JP6.4, R13.1, SJ3.1, U5.5, U5.14
GND3: C22.2, C23.2, C25.2, C26.1, C27.2, C28.2, J4.5, JP8.1, JP8.4, R18.1, SJ4.1, U8.5, U8.14
GND4: C29.2, C30.2, C32.2, C33.1, C34.2, C35.2, J5.5, JP10.1, JP10.4, R23.1, SJ5.1, U10.5, U10.14
GND5: C36.2, C37.2, C39.2, C40.1, C41.2, C42.2, J6.5, JP12.1, JP12.4, R28.1, SJ6.1, U12.5, U12.14
GND6: C43.2, C44.2, C46.2, C47.1, C48.2, C49.2, J7.5, JP14.1, JP14.4, R33.1, SJ7.1, U14.5, U14.14
GND7: C50.2, C51.2, C53.2, C54.1, C55.2, C56.2, J8.5, JP16.1, JP16.4, R38.1, SJ8.1, U16.5, U16.14
GND8: C57.2, C58.2, C60.2, C61.1, C62.2, C63.2, J9.5, JP18.1, JP18.4, R43.1, SJ9.1, U18.5, U18.14
GND9: C64.2, C65.2, C67.2, C68.1, C69.2, C70.2, J10.5, JP20.1, JP20.4, R48.1, SJ10.1, U20.5, U20.14
GND10: C71.2, C72.2, C74.2, C75.1, C76.2, C77.2, J11.5, JP22.1, JP22.4, R53.1, SJ11.1, U22.5, U22.14
GND11: C78.2, C79.2, C81.2, C82.1, C83.2, C84.2, J12.5, JP24.1, JP24.4, R58.1, SJ12.1, U24.5, U24.14
GND12: C85.2, C86.2, C88.2, C89.1, C90.2, C91.2, J13.5, JP26.1, JP26.4, R63.1, SJ13.1, U26.5, U26.14
GND13: C92.2, C93.2, C95.2, C96.1, C97.2, C98.2, J14.5, JP28.1, JP28.4, R68.1, SJ14.1, U28.5, U28.14
GND14: C99.2, C100.2, C102.2, C103.1, C104.2, C105.2, J15.5, JP30.1, JP30.4, R73.1, SJ15.1, U30.5, U30.14
GND15: C106.2, C107.2, C109.2, C110.1, C111.2, C112.2, J16.5, JP32.1, JP32.4, R78.1, SJ16.1, U32.5, U32.14
GND16: C113.2, C114.2, C116.2, C117.1, C118.2, C119.2, J17.5, JP34.1, JP34.4, R83.1, SJ17.1, U34.5, U34.14
GND17: C120.2, C121.2, C123.2, C124.1, C125.2, C126.2, J18.5, JP36.1, JP36.4, R88.1, SJ18.1, U36.5, U36.14
GND18: C127.2, C128.2, C130.2, C131.1, C132.2, C133.2, J19.5, JP38.1, JP38.4, R93.1, SJ19.1, U38.5, U38.14
GND19: C134.2, C135.2, C137.2, C138.1, C139.2, C140.2, J20.5, JP40.1, JP40.4, R98.1, SJ20.1, U40.5, U40.14
GND20: C141.2, C142.2, C144.2, C145.1, C146.2, C147.2, J21.5, JP42.1, JP42.4, R103.1, SJ21.1, U42.5, U42.14
GND21: C148.2, C149.2, C151.2, C152.1, C153.2, C154.2, J22.5, JP44.1, JP44.4, R108.1, SJ22.1, U44.5, U44.14
GND22: C155.2, C156.2, C158.2, C159.1, C160.2, C161.2, J23.5, JP46.1, JP46.4, R113.1, SJ23.1, U46.5, U46.14
GND23: C162.2, C163.2, C165.2, C166.1, C167.2, C168.2, J24.5, JP48.1, JP48.4, R118.1, SJ24.1, U48.5, U48.14
GND24: C169.2, C170.2, C172.2, C173.1, C174.2, C175.2, J25.5, JP50.1, JP50.4, R123.1, SJ25.1, U50.5, U50.14
GND25: C176.2, C177.2, C179.2, C180.1, C181.2, C182.2, J26.5, JP52.1, JP52.4, R128.1, SJ26.1, U52.5, U52.14
GND26: C183.2, C184.2, C186.2, C187.1, C188.2, C189.2, J27.5, JP54.1, JP54.4, R133.1, SJ27.1, U54.5, U54.14
GND27: C190.2, C191.2, C193.2, C194.1, C195.2, C196.2, J28.5, JP56.1, JP56.4, R138.1, SJ28.1, U56.5, U56.14
GND28: C197.2, C198.2, C200.2, C201.1, C202.2, C203.2, J29.5, JP58.1, JP58.4, R143.1, SJ29.1, U58.5, U58.14
GND29: C204.2, C205.2, C207.2, C208.1, C209.2, C210.2, J30.5, JP60.1, JP60.4, R148.1, SJ30.1, U60.5, U60.14
GND30: C211.2, C212.2, C214.2, C215.1, C216.2, C217.2, J31.5, JP62.1, JP62.4, R153.1, SJ31.1, U62.5, U62.14
GND31: C218.2, C219.2, C221.2, C222.1, C223.2, C224.2, J32.5, JP64.1, JP64.4, R158.1, SJ32.1, U64.5, U64.14
GND32: C225.2, C226.2, C228.2, C229.1, C230.2, C231.2, J33.5, JP66.1, JP66.4, R163.1, SJ33.1, U66.5, U66.14
GND33: C232.2, C233.2, C235.2, C236.1, C237.2, C238.2, J34.5, JP68.1, JP68.4, R168.1, SJ34.1, U68.5, U68.14
GND34: C239.2, C240.2, C242.2, C243.1, C244.2, C245.2, J35.5, JP70.1, JP70.4, R173.1, SJ35.1, U70.5, U70.14
GND35: C246.2, C247.2, C249.2, C250.1, C251.2, C252.2, J36.5, JP72.1, JP72.4, R178.1, SJ36.1, U72.5, U72.14
GND36: C253.2, C254.2, C256.2, C257.1, C258.2, C259.2, J37.5, JP74.1, JP74.4, R183.1, SJ37.1, U74.5, U74.14
GND37: C260.2, C261.2, C263.2, C264.1, C265.2, C266.2, J38.5, JP76.1, JP76.4, R188.1, SJ38.1, U76.5, U76.14
GND38: C267.2, C268.2, C270.2, C271.1, C272.2, C273.2, J39.5, JP78.1, JP78.4, R193.1, SJ39.1, U78.5, U78.14
GND39: C274.2, C275.2, C277.2, C278.1, C279.2, C280.2, J40.5, JP80.1, JP80.4, R198.1, SJ40.1, U80.5, U80.14
unnamed: R5.1, SJ2.2, U1.15
unnamed: C1.1, R3.2, U1.7
unnamed: C1.2, R4.2, U1.8
unnamed: Q1.1, U1.2
unnamed: L1.2, Q1.3, R1.2, U1.3
unnamed: R1.1, R2.2, U1.4
unnamed: C2.2, U1.6
unnamed: Q2.1, U3.2
unnamed: R8.2, R9.1, U3.4
unnamed: C12.2, U3.6
unnamed: L2.2, Q2.3, R9.2, U3.3
unnamed: R10.1, SJ1.2, U3.15
unnamed: C10.1, R6.2, U3.7
unnamed: C10.2, R7.2, U3.8
unnamed: Q3.1, U5.2
unnamed: R13.2, R14.1, U5.4
unnamed: C19.2, U5.6
unnamed: L3.2, Q3.3, R14.2, U5.3
unnamed: R15.1, SJ3.2, U5.15
unnamed: C17.1, R11.2, U5.7
unnamed: C17.2, R12.2, U5.8
unnamed: Q4.1, U8.2
unnamed: R18.2, R19.1, U8.4
unnamed: C26.2, U8.6
unnamed: L4.2, Q4.3, R19.2, U8.3
unnamed: R20.1, SJ4.2, U8.15
unnamed: C24.1, R16.2, U8.7
unnamed: C24.2, R17.2, U8.8
unnamed: Q5.1, U10.2
unnamed: R23.2, R24.1, U10.4
unnamed: C33.2, U10.6
unnamed: L5.2, Q5.3, R24.2, U10.3
unnamed: R25.1, SJ5.2, U10.15
unnamed: C31.1, R21.2, U10.7
unnamed: C31.2, R22.2, U10.8
unnamed: Q6.1, U12.2
unnamed: R28.2, R29.1, U12.4
unnamed: C40.2, U12.6
unnamed: L6.2, Q6.3, R29.2, U12.3
unnamed: R30.1, SJ6.2, U12.15
unnamed: C38.1, R26.2, U12.7
unnamed: C38.2, R27.2, U12.8
unnamed: Q7.1, U14.2
unnamed: R33.2, R34.1, U14.4
unnamed: C47.2, U14.6
unnamed: L7.2, Q7.3, R34.2, U14.3
unnamed: R35.1, SJ7.2, U14.15
unnamed: C45.1, R31.2, U14.7
unnamed: C45.2, R32.2, U14.8
unnamed: Q8.1, U16.2
unnamed: R38.2, R39.1, U16.4
unnamed: C54.2, U16.6
unnamed: L8.2, Q8.3, R39.2, U16.3
unnamed: R40.1, SJ8.2, U16.15
unnamed: C52.1, R36.2, U16.7
unnamed: C52.2, R37.2, U16.8
unnamed: Q9.1, U18.2
unnamed: R43.2, R44.1, U18.4
unnamed: C61.2, U18.6
unnamed: L9.2, Q9.3, R44.2, U18.3
unnamed: R45.1, SJ9.2, U18.15
unnamed: C59.1, R41.2, U18.7
unnamed: C59.2, R42.2, U18.8
unnamed: Q10.1, U20.2
unnamed: R48.2, R49.1, U20.4
unnamed: C68.2, U20.6
unnamed: L10.2, Q10.3, R49.2, U20.3
unnamed: R50.1, SJ10.2, U20.15
unnamed: C66.1, R46.2, U20.7
unnamed: C66.2, R47.2, U20.8
unnamed: Q11.1, U22.2
unnamed: R53.2, R54.1, U22.4
unnamed: C75.2, U22.6
unnamed: L11.2, Q11.3, R54.2, U22.3
unnamed: R55.1, SJ11.2, U22.15
unnamed: C73.1, R51.2, U22.7
unnamed: C73.2, R52.2, U22.8
unnamed: Q12.1, U24.2
unnamed: R58.2, R59.1, U24.4
unnamed: C82.2, U24.6
unnamed: L12.2, Q12.3, R59.2, U24.3
unnamed: R60.1, SJ12.2, U24.15
unnamed: C80.1, R56.2, U24.7
unnamed: C80.2, R57.2, U24.8
unnamed: Q13.1, U26.2
unnamed: R63.2, R64.1, U26.4
unnamed: C89.2, U26.6
unnamed: L13.2, Q13.3, R64.2, U26.3
unnamed: R65.1, SJ13.2, U26.15
unnamed: C87.1, R61.2, U26.7
unnamed: C87.2, R62.2, U26.8
unnamed: Q14.1, U28.2
unnamed: R68.2, R69.1, U28.4
unnamed: C96.2, U28.6
unnamed: L14.2, Q14.3, R69.2, U28.3
unnamed: R70.1, SJ14.2, U28.15
unnamed: C94.1, R66.2, U28.7
unnamed: C94.2, R67.2, U28.8
unnamed: Q15.1, U30.2
unnamed: R73.2, R74.1, U30.4
unnamed: C103.2, U30.6
unnamed: L15.2, Q15.3, R74.2, U30.3
unnamed: R75.1, SJ15.2, U30.15
unnamed: C101.1, R71.2, U30.7
unnamed: C101.2, R72.2, U30.8
unnamed: Q16.1, U32.2
unnamed: R78.2, R79.1, U32.4
unnamed: C110.2, U32.6
unnamed: L16.2, Q16.3, R79.2, U32.3
unnamed: R80.1, SJ16.2, U32.15
unnamed: C108.1, R76.2, U32.7
unnamed: C108.2, R77.2, U32.8
unnamed: Q17.1, U34.2
unnamed: R83.2, R84.1, U34.4
unnamed: C117.2, U34.6
unnamed: L17.2, Q17.3, R84.2, U34.3
unnamed: R85.1, SJ17.2, U34.15
unnamed: C115.1, R81.2, U34.7
unnamed: C115.2, R82.2, U34.8
unnamed: Q18.1, U36.2
unnamed: R88.2, R89.1, U36.4
unnamed: C124.2, U36.6
unnamed: L18.2, Q18.3, R89.2, U36.3
unnamed: R90.1, SJ18.2, U36.15
unnamed: C122.1, R86.2, U36.7
unnamed: C122.2, R87.2, U36.8
unnamed: Q19.1, U38.2
unnamed: R93.2, R94.1, U38.4
unnamed: C131.2, U38.6
unnamed: L19.2, Q19.3, R94.2, U38.3
unnamed: R95.1, SJ19.2, U38.15
unnamed: C129.1, R91.2, U38.7
unnamed: C129.2, R92.2, U38.8
unnamed: Q20.1, U40.2
unnamed: R98.2, R99.1, U40.4
unnamed: C138.2, U40.6
unnamed: L20.2, Q20.3, R99.2, U40.3
unnamed: R100.1, SJ20.2, U40.15
unnamed: C136.1, R96.2, U40.7
unnamed: C136.2, R97.2, U40.8
unnamed: Q21.1, U42.2
unnamed: R103.2, R104.1, U42.4
unnamed: C145.2, U42.6
unnamed: L21.2, Q21.3, R104.2, U42.3
unnamed: R105.1, SJ21.2, U42.15
unnamed: C143.1, R101.2, U42.7
unnamed: C143.2, R102.2, U42.8
unnamed: Q22.1, U44.2
unnamed: R108.2, R109.1, U44.4
unnamed: C152.2, U44.6
unnamed: L22.2, Q22.3, R109.2, U44.3
unnamed: R110.1, SJ22.2, U44.15
unnamed: C150.1, R106.2, U44.7
unnamed: C150.2, R107.2, U44.8
unnamed: Q23.1, U46.2
unnamed: R113.2, R114.1, U46.4
unnamed: C159.2, U46.6
unnamed: L23.2, Q23.3, R114.2, U46.3
unnamed: R115.1, SJ23.2, U46.15
unnamed: C157.1, R111.2, U46.7
unnamed: C157.2, R112.2, U46.8
unnamed: Q24.1, U48.2
unnamed: R118.2, R119.1, U48.4
unnamed: C166.2, U48.6
unnamed: L24.2, Q24.3, R119.2, U48.3
unnamed: R120.1, SJ24.2, U48.15
unnamed: C164.1, R116.2, U48.7
unnamed: C164.2, R117.2, U48.8
unnamed: Q25.1, U50.2
unnamed: R123.2, R124.1, U50.4
unnamed: C173.2, U50.6
unnamed: L25.2, Q25.3, R124.2, U50.3
unnamed: R125.1, SJ25.2, U50.15
unnamed: C171.1, R121.2, U50.7
unnamed: C171.2, R122.2, U50.8
unnamed: Q26.1, U52.2
unnamed: R128.2, R129.1, U52.4
unnamed: C180.2, U52.6
unnamed: L26.2, Q26.3, R129.2, U52.3
unnamed: R130.1, SJ26.2, U52.15
unnamed: C178.1, R126.2, U52.7
unnamed: C178.2, R127.2, U52.8
unnamed: Q27.1, U54.2
unnamed: R133.2, R134.1, U54.4
unnamed: C187.2, U54.6
unnamed: L27.2, Q27.3, R134.2, U54.3
unnamed: R135.1, SJ27.2, U54.15
unnamed: C185.1, R131.2, U54.7
unnamed: C185.2, R132.2, U54.8
unnamed: Q28.1, U56.2
unnamed: R138.2, R139.1, U56.4
unnamed: C194.2, U56.6
unnamed: L28.2, Q28.3, R139.2, U56.3
unnamed: R140.1, SJ28.2, U56.15
unnamed: C192.1, R136.2, U56.7
unnamed: C192.2, R137.2, U56.8
unnamed: Q29.1, U58.2
unnamed: R143.2, R144.1, U58.4
unnamed: C201.2, U58.6
unnamed: L29.2, Q29.3, R144.2, U58.3
unnamed: R145.1, SJ29.2, U58.15
unnamed: C199.1, R141.2, U58.7
unnamed: C199.2, R142.2, U58.8
unnamed: Q30.1, U60.2
unnamed: R148.2, R149.1, U60.4
unnamed: C208.2, U60.6
unnamed: L30.2, Q30.3, R149.2, U60.3
unnamed: R150.1, SJ30.2, U60.15
unnamed: C206.1, R146.2, U60.7
unnamed: C206.2, R147.2, U60.8
unnamed: Q31.1, U62.2
unnamed: R153.2, R154.1, U62.4
unnamed: C215.2, U62.6
unnamed: L31.2, Q31.3, R154.2, U62.3
unnamed: R155.1, SJ31.2, U62.15
unnamed: C213.1, R151.2, U62.7
unnamed: C213.2, R152.2, U62.8
unnamed: Q32.1, U64.2
unnamed: R158.2, R159.1, U64.4
unnamed: C222.2, U64.6
unnamed: L32.2, Q32.3, R159.2, U64.3
unnamed: R160.1, SJ32.2, U64.15
unnamed: C220.1, R156.2, U64.7
unnamed: C220.2, R157.2, U64.8
unnamed: Q33.1, U66.2
unnamed: R163.2, R164.1, U66.4
unnamed: C229.2, U66.6
unnamed: L33.2, Q33.3, R164.2, U66.3
unnamed: R165.1, SJ33.2, U66.15
unnamed: C227.1, R161.2, U66.7
unnamed: C227.2, R162.2, U66.8
unnamed: Q34.1, U68.2
unnamed: R168.2, R169.1, U68.4
unnamed: C236.2, U68.6
unnamed: L34.2, Q34.3, R169.2, U68.3
unnamed: R170.1, SJ34.2, U68.15
unnamed: C234.1, R166.2, U68.7
unnamed: C234.2, R167.2, U68.8
unnamed: Q35.1, U70.2
unnamed: R173.2, R174.1, U70.4
unnamed: C243.2, U70.6
unnamed: L35.2, Q35.3, R174.2, U70.3
unnamed: R175.1, SJ35.2, U70.15
unnamed: C241.1, R171.2, U70.7
unnamed: C241.2, R172.2, U70.8
unnamed: Q36.1, U72.2
unnamed: R178.2, R179.1, U72.4
unnamed: C250.2, U72.6
unnamed: L36.2, Q36.3, R179.2, U72.3
unnamed: R180.1, SJ36.2, U72.15
unnamed: C248.1, R176.2, U72.7
unnamed: C248.2, R177.2, U72.8
unnamed: Q37.1, U74.2
unnamed: R183.2, R184.1, U74.4
unnamed: C257.2, U74.6
unnamed: L37.2, Q37.3, R184.2, U74.3
unnamed: R185.1, SJ37.2, U74.15
unnamed: C255.1, R181.2, U74.7
unnamed: C255.2, R182.2, U74.8
unnamed: Q38.1, U76.2
unnamed: R188.2, R189.1, U76.4
unnamed: C264.2, U76.6
unnamed: L38.2, Q38.3, R189.2, U76.3
unnamed: R190.1, SJ38.2, U76.15
unnamed: C262.1, R186.2, U76.7
unnamed: C262.2, R187.2, U76.8
unnamed: Q39.1, U78.2
unnamed: R193.2, R194.1, U78.4
unnamed: C271.2, U78.6
unnamed: L39.2, Q39.3, R194.2, U78.3
unnamed: R195.1, SJ39.2, U78.15
unnamed: C269.1, R191.2, U78.7
unnamed: C269.2, R192.2, U78.8
unnamed: Q40.1, U80.2
unnamed: R198.2, R199.1, U80.4
unnamed: C278.2, U80.6
unnamed: L40.2, Q40.3, R199.2, U80.3
unnamed: R200.1, SJ40.2, U80.15
unnamed: C276.1, R196.2, U80.7
unnamed: C276.2, R197.2, U80.8
SCK: J1.4, U1.11
SCK1: J2.4, U3.11
SCK2: J3.4, U5.11
SCK3: J4.4, U8.11
SCK4: J5.4, U10.11
SCK5: J6.4, U12.11
SCK6: J7.4, U14.11
SCK7: J8.4, U16.11
SCK8: J9.4, U18.11
SCK9: J10.4, U20.11
SCK10: J11.4, U22.11
SCK11: J12.4, U24.11
SCK12: J13.4, U26.11
SCK13: J14.4, U28.11
SCK14: J15.4, U30.11
SCK15: J16.4, U32.11
SCK16: J17.4, U34.11
SCK17: J18.4, U36.11
SCK18: J19.4, U38.11
SCK19: J20.4, U40.11
SCK20: J21.4, U42.11
SCK21: J22.4, U44.11
SCK22: J23.4, U46.11
SCK23: J24.4, U48.11
SCK24: J25.4, U50.11
SCK25: J26.4, U52.11
SCK26: J27.4, U54.11
SCK27: J28.4, U56.11
SCK28: J29.4, U58.11
SCK29: J30.4, U60.11
SCK30: J31.4, U62.11
SCK31: J32.4, U64.11
SCK32: J33.4, U66.11
SCK33: J34.4, U68.11
SCK34: J35.4, U70.11
SCK35: J36.4, U72.11
SCK36: J37.4, U74.11
SCK37: J38.4, U76.11
SCK38: J39.4, U78.11
SCK39: J40.4, U80.11
VCC: C5.1, C6.1, J1.2, Q1.2, R5.2, U1.1
VCC1: C8.1, C11.1, J2.2, Q2.2, R10.2, U3.1
VCC2: C15.1, C18.1, J3.2, Q3.2, R15.2, U5.1
VCC3: C22.1, C25.1, J4.2, Q4.2, R20.2, U8.1
VCC4: C29.1, C32.1, J5.2, Q5.2, R25.2, U10.1
VCC5: C36.1, C39.1, J6.2, Q6.2, R30.2, U12.1
VCC6: C43.1, C46.1, J7.2, Q7.2, R35.2, U14.1
VCC7: C50.1, C53.1, J8.2, Q8.2, R40.2, U16.1
VCC8: C57.1, C60.1, J9.2, Q9.2, R45.2, U18.1
VCC9: C64.1, C67.1, J10.2, Q10.2, R50.2, U20.1
VCC10: C71.1, C74.1, J11.2, Q11.2, R55.2, U22.1
VCC11: C78.1, C81.1, J12.2, Q12.2, R60.2, U24.1
VCC12: C85.1, C88.1, J13.2, Q13.2, R65.2, U26.1
VCC13: C92.1, C95.1, J14.2, Q14.2, R70.2, U28.1
VCC14: C99.1, C102.1, J15.2, Q15.2, R75.2, U30.1
VCC15: C106.1, C109.1, J16.2, Q16.2, R80.2, U32.1
VCC16: C113.1, C116.1, J17.2, Q17.2, R85.2, U34.1
VCC17: C120.1, C123.1, J18.2, Q18.2, R90.2, U36.1
VCC18: C127.1, C130.1, J19.2, Q19.2, R95.2, U38.1
VCC19: C134.1, C137.1, J20.2, Q20.2, R100.2, U40.1
VCC20: C141.1, C144.1, J21.2, Q21.2, R105.2, U42.1
VCC21: C148.1, C151.1, J22.2, Q22.2, R110.2, U44.1
VCC22: C155.1, C158.1, J23.2, Q23.2, R115.2, U46.1
VCC23: C162.1, C165.1, J24.2, Q24.2, R120.2, U48.1
VCC24: C169.1, C172.1, J25.2, Q25.2, R125.2, U50.1
VCC25: C176.1, C179.1, J26.2, Q26.2, R130.2, U52.1
VCC26: C183.1, C186.1, J27.2, Q27.2, R135.2, U54.1
VCC27: C190.1, C193.1, J28.2, Q28.2, R140.2, U56.1
VCC28: C197.1, C200.1, J29.2, Q29.2, R145.2, U58.1
VCC29: C204.1, C207.1, J30.2, Q30.2, R150.2, U60.1
VCC30: C211.1, C214.1, J31.2, Q31.2, R155.2, U62.1
VCC31: C218.1, C221.1, J32.2, Q32.2, R160.2, U64.1
VCC32: C225.1, C228.1, J33.2, Q33.2, R165.2, U66.1
VCC33: C232.1, C235.1, J34.2, Q34.2, R170.2, U68.1
VCC34: C239.1, C242.1, J35.2, Q35.2, R175.2, U70.1
VCC35: C246.1, C249.1, J36.2, Q36.2, R180.2, U72.1
VCC36: C253.1, C256.1, J37.2, Q37.2, R185.2, U74.1
VCC37: C260.1, C263.1, J38.2, Q38.2, R190.2, U76.1
VCC38: C267.1, C270.1, J39.2, Q39.2, R195.2, U78.1
VCC39: C274.1, C277.1, J40.2, Q40.2, R200.2, U80.1
VDD: C4.1, J1.1, U1.16
VDD1: C14.1, J2.1, U3.16
VDD2: C21.1, J3.1, U5.16
VDD3: C28.1, J4.1, U8.16
VDD4: C35.1, J5.1, U10.16
VDD5: C42.1, J6.1, U12.16
VDD6: C49.1, J7.1, U14.16
VDD7: C56.1, J8.1, U16.16
VDD8: C63.1, J9.1, U18.16
VDD9: C70.1, J10.1, U20.16
VDD10: C77.1, J11.1, U22.16
VDD11: C84.1, J12.1, U24.16
VDD12: C91.1, J13.1, U26.16
VDD13: C98.1, J14.1, U28.16
VDD14: C105.1, J15.1, U30.16
VDD15: C112.1, J16.1, U32.16
VDD16: C119.1, J17.1, U34.16
VDD17: C126.1, J18.1, U36.16
VDD18: C133.1, J19.1, U38.16
VDD19: C140.1, J20.1, U40.16
VDD20: C147.1, J21.1, U42.16
VDD21: C154.1, J22.1, U44.16
VDD22: C161.1, J23.1, U46.16
VDD23: C168.1, J24.1, U48.16
VDD24: C175.1, J25.1, U50.16
VDD25: C182.1, J26.1, U52.16
VDD26: C189.1, J27.1, U54.16
VDD27: C196.1, J28.1, U56.16
VDD28: C203.1, J29.1, U58.16
VDD29: C210.1, J30.1, U60.16
VDD30: C217.1, J31.1, U62.16
VDD31: C224.1, J32.1, U64.16
VDD32: C231.1, J33.1, U66.16
VDD33: C238.1, J34.1, U68.16
VDD34: C245.1, J35.1, U70.16
VDD35: C252.1, J36.1, U72.16
VDD36: C259.1, J37.1, U74.16
VDD37: C266.1, J38.1, U76.16
VDD38: C273.1, J39.1, U78.16
VDD39: C280.1, J40.1, U80.16
