m3l1k4/Capstone_F19_Group_110/azure/config.h

/*
* IoT Hub Raspberry Pi C - Microsoft Sample Code - Copyright (c) 2017 - Licensed MIT
*/

#ifndef CONFIG_H_
#define CONFIG_H_

#define INTERVAL 2000
#define SIMULATED_DATA 1
#define BUFFER_SIZE 256

#define LED_PIN 7

#define CREDENTIAL_PATH "~/.iot-hub"

#endif  // CONFIG_H_
