m3l1k4/Capstone_F19_Group_110/(commit log)

2019-11-14 round one purchases
    [Capstone Parts.xlsx]
2019-11-25 azure hub set up_ pending send fix
    [bme280.c, bme280.h, config.h, parson.c, parson.h, telemetry.c, telemetry.h, wiring.c]
2019-11-25 azure setup need rec fix
    [bme280.c, bme280.h, config.h, parson.c, parson.h, telemetry.c, telemetry.h, wiring.c]
2020-01-09 Load Cell Initial Commit
    [SparkFun_HX711_Load_Cell-Panel-v11.brd, SparkFun_HX711_Load_Cell.brd, SparkFun_HX711_Load_Cell.sch]
2020-01-28 Sample receiving code for Rpi
2020-02-05 no errors however value readins are constant ( we don;t want constant)
    [caliberation_sketch_for_HX711.ino]
2020-02-26 3D CAD files
    [Load cell dock.STL, Pressure plate proto.STL]
2020-02-29 gravity dispenser short version
    [dispneser 150x150 v22.stl]
2020-03-04 3D disp body
    [dispneser 150x150 v22.stl, dispneser 150x150 v26.stl]
2020-04-04 solidworks files and calibration code
    [Load cell dock.SLDDRW, Load cell dock.SLDPRT, Load cell dock.STL, Load cell.SLDPRT, Milestone 3.SLDASM, Pressure plate proto.SLDDRW, Pressure plate proto.SLDPRT, Pressure plate proto.STL]
